Zighhi/DSPAmp/thesis/Appendix1.tex

\chapter{Schema Hardware a Sistemului}
\label{anexa:hardware}

\vspace{-2cm}
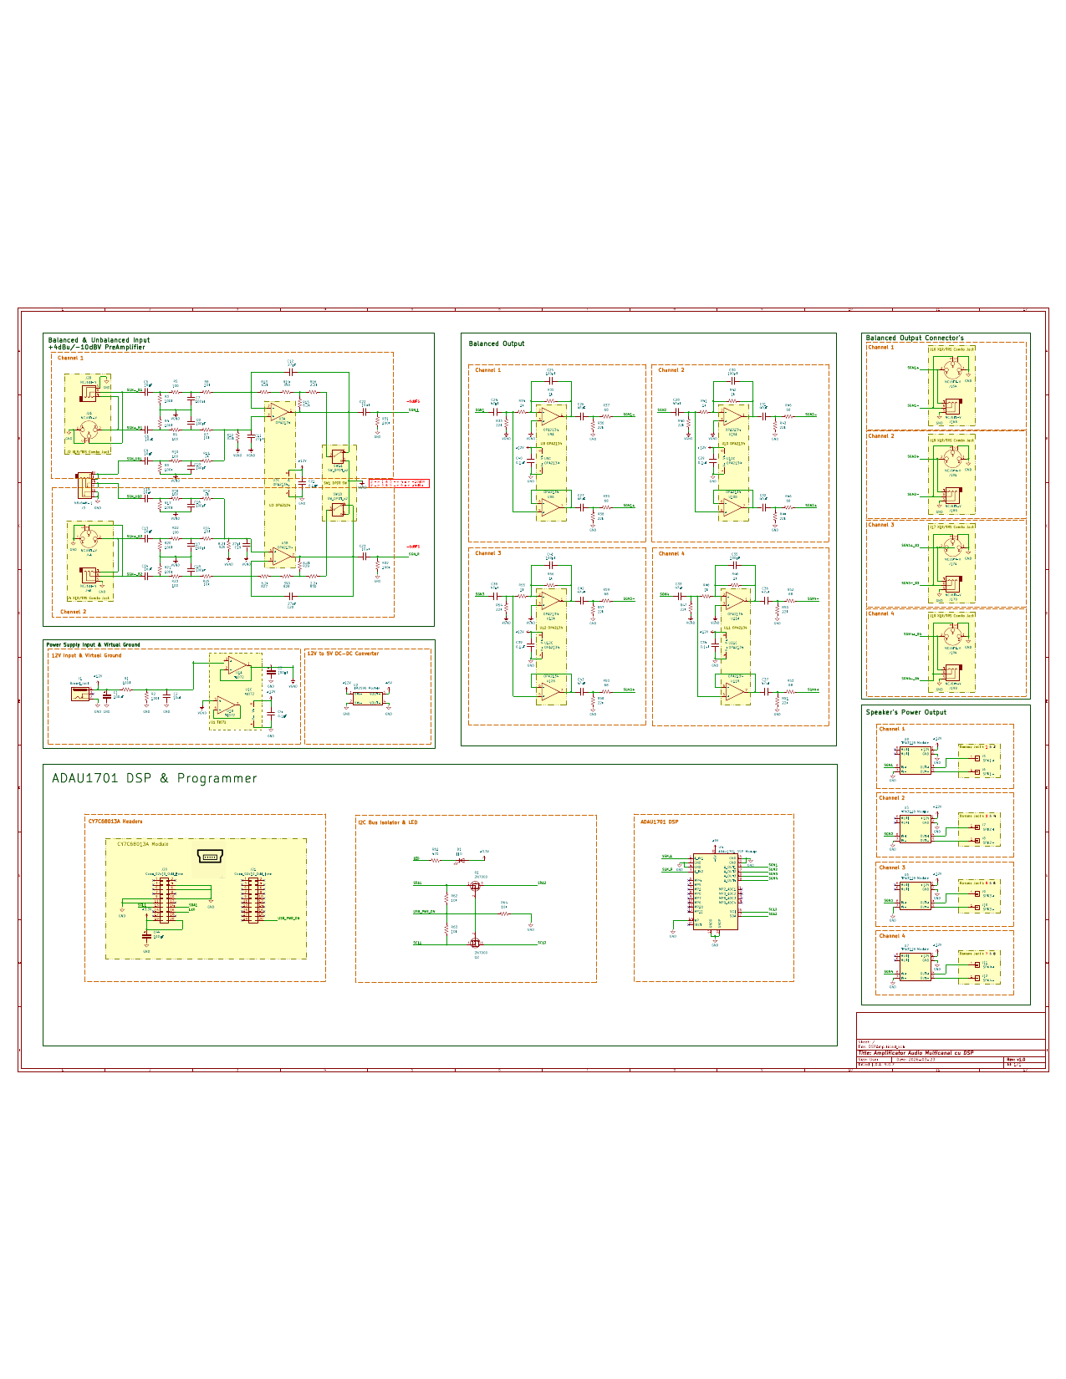
[picture p4: thesis/figuri/schema_completa.png]
\noindent
