Zighhi/DSPAmp/docs/images/block_diagram.png

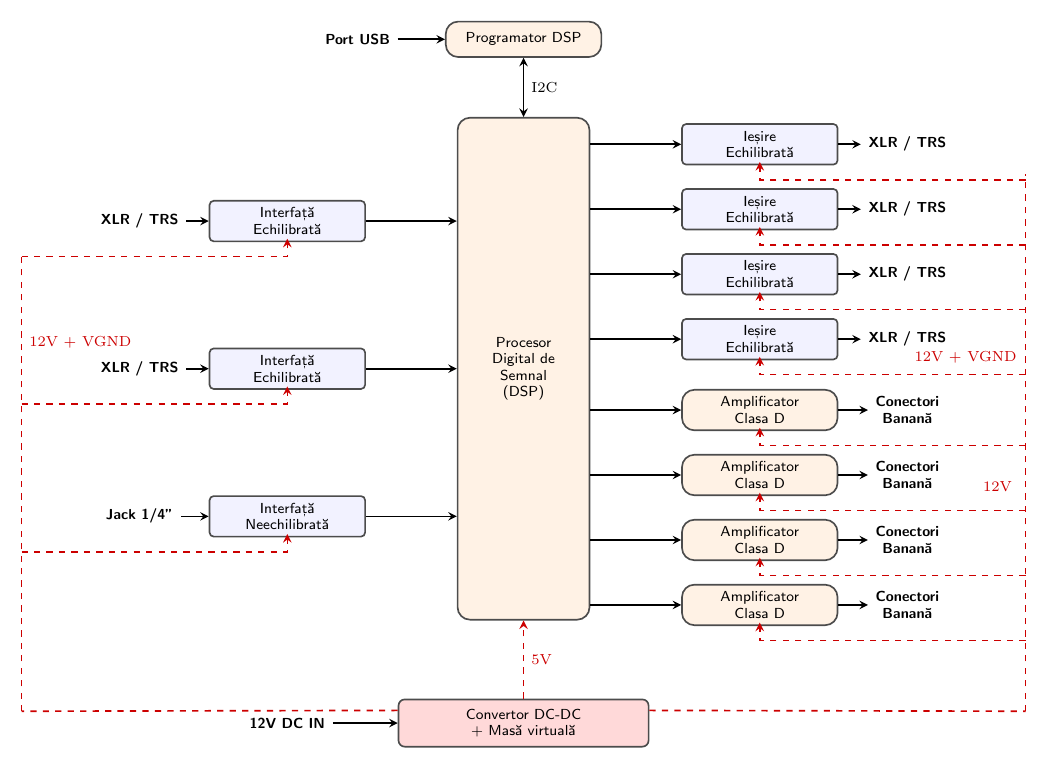
docs/images/block_diagram.png
