Zighhi/DSPAmp/hardware/DSPAmp_schematic.pdf

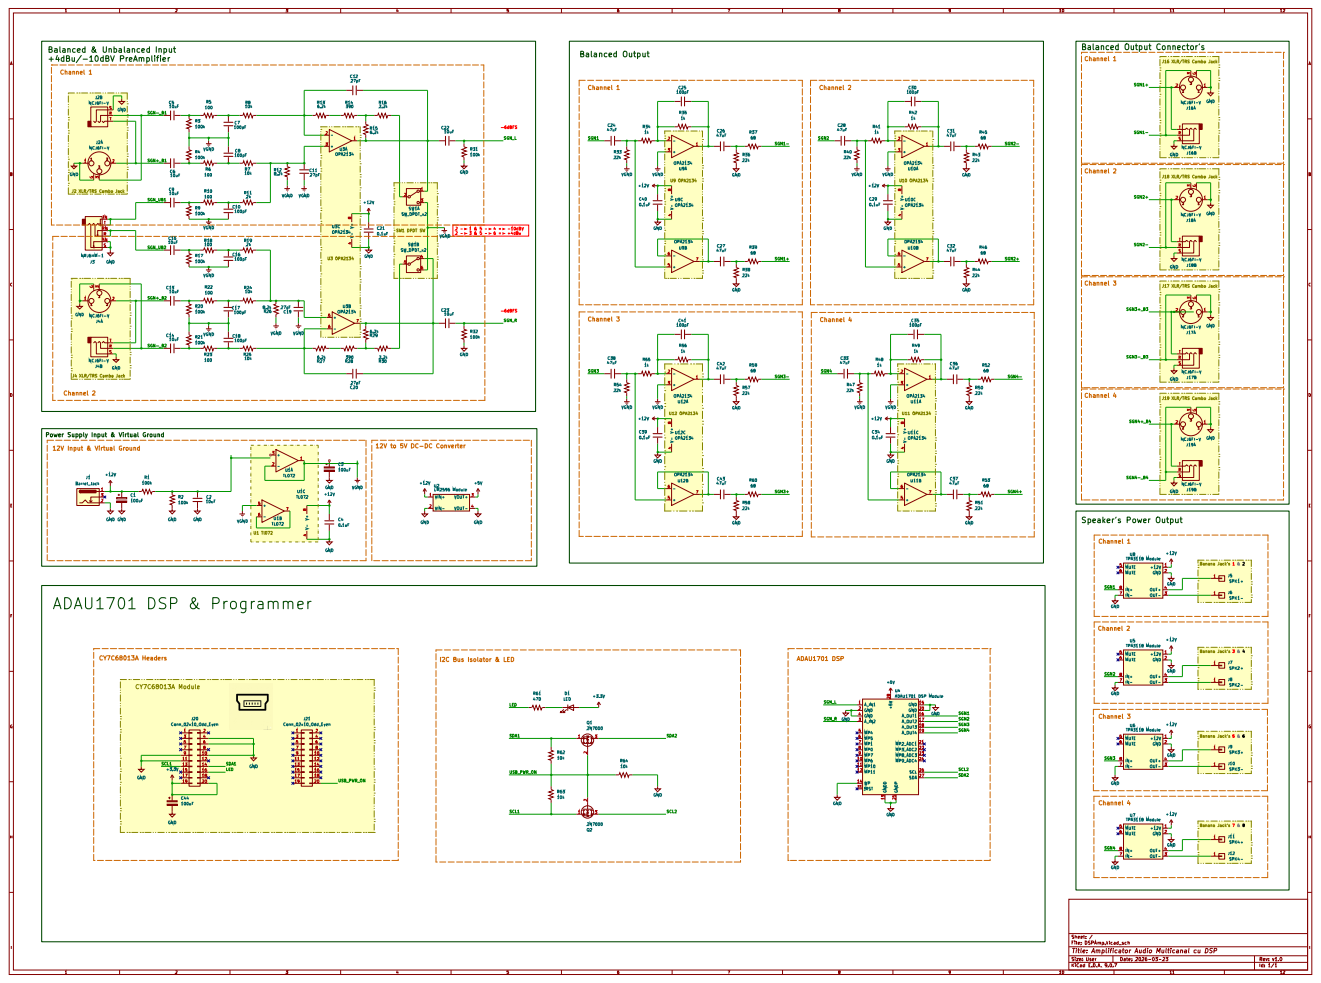
[picture p31: page 1]
