Zighhi/DSPAmp/thesis/figuri/cmrr_signals.pdf

101

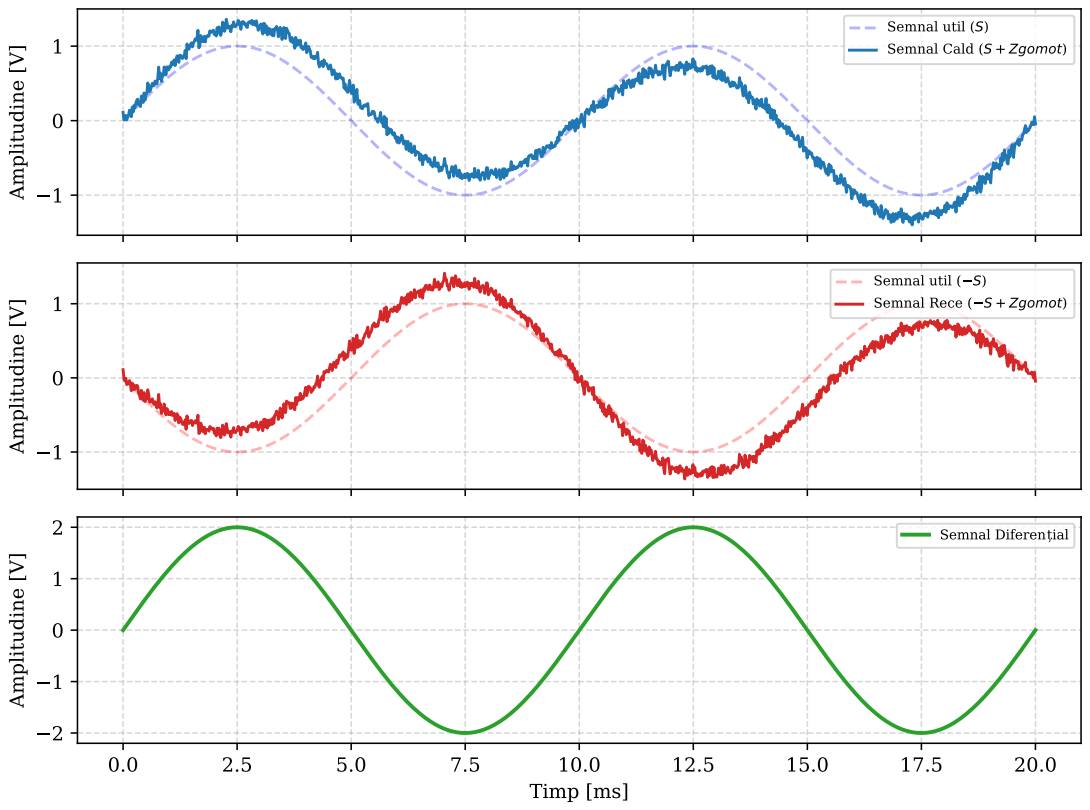
[picture p33: page 1]
Amplitudine [V]; Timp [ms]

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

Semnal Diferen ial
