Zighhi/DSPAmp/thesis/figuri/freq_resp_input.pdf

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

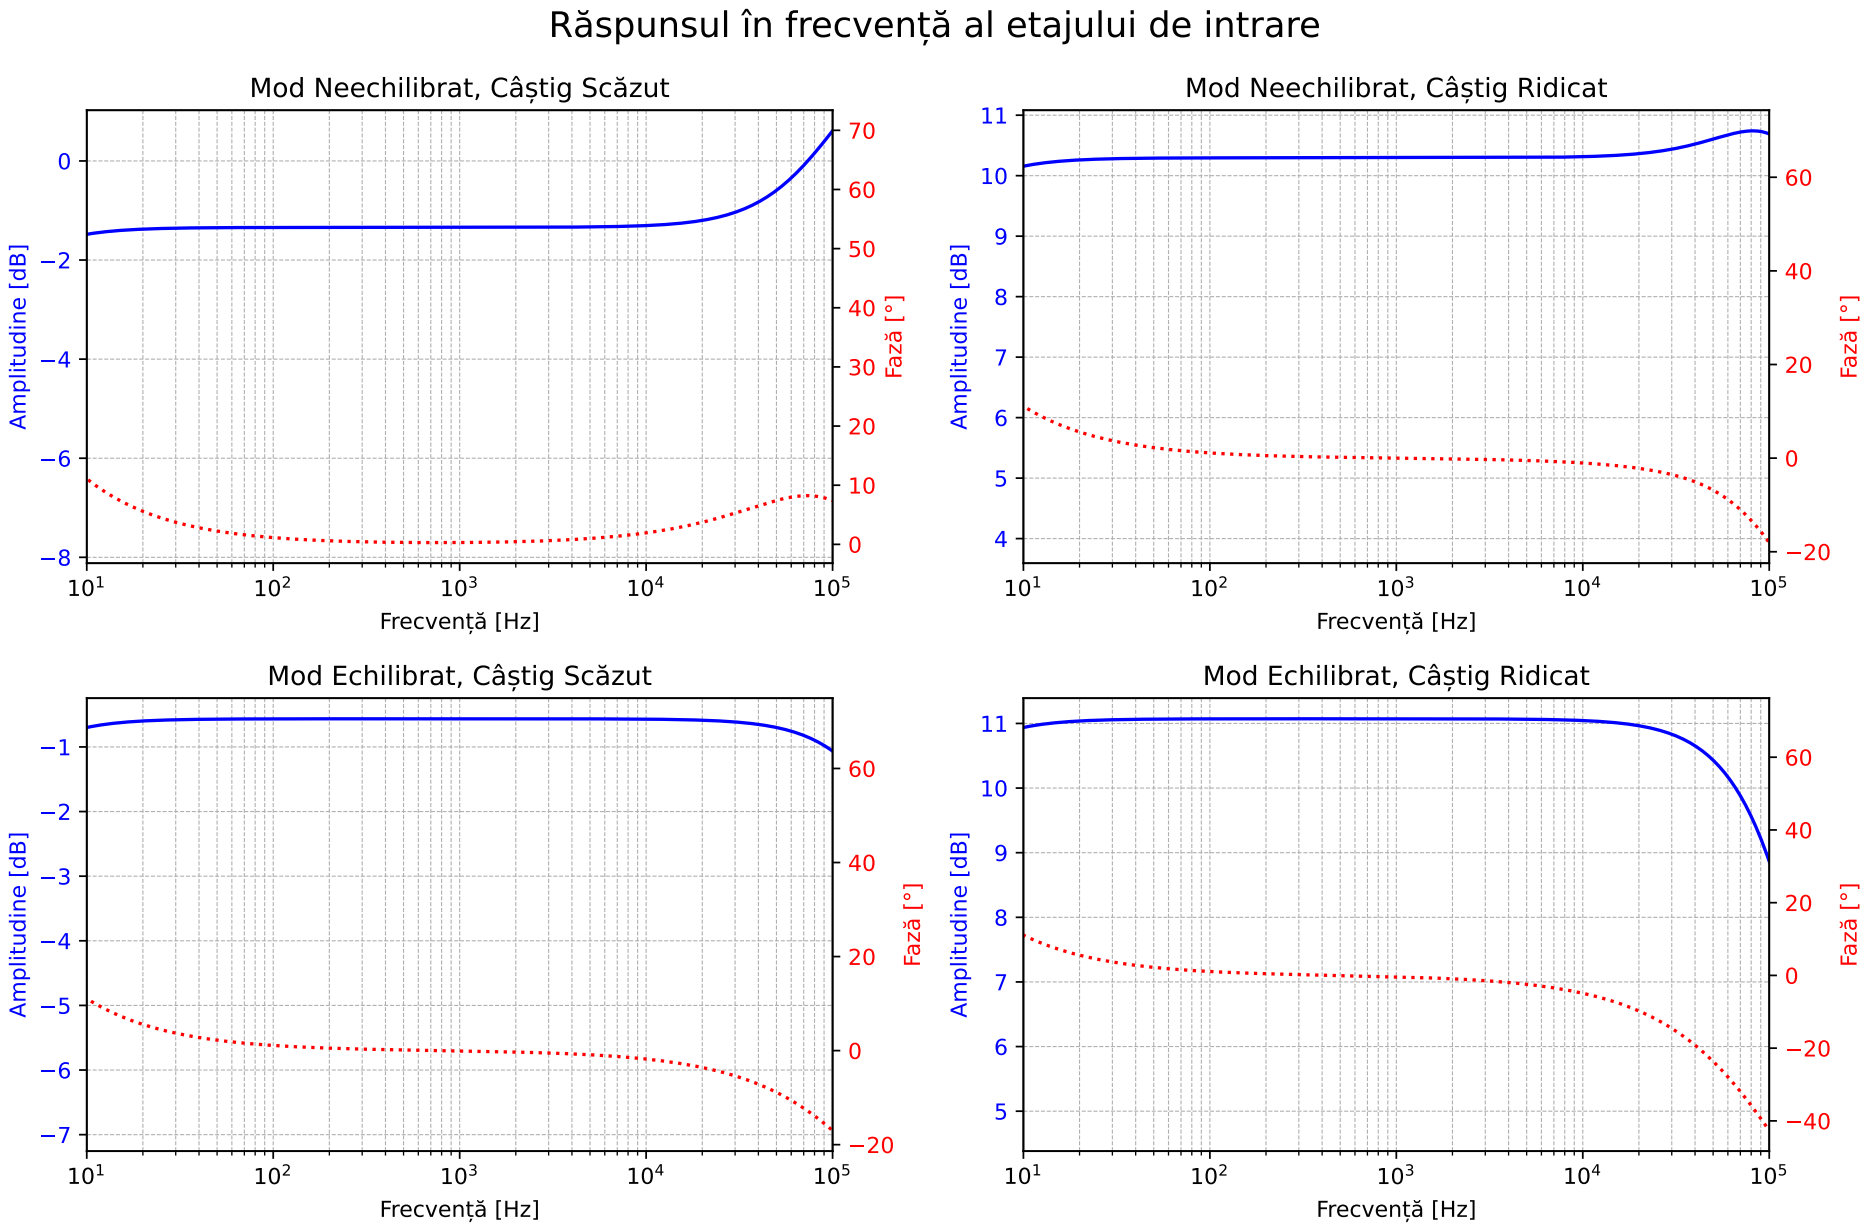
[picture p35: page 1]
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
