Zighhi/DSPAmp/simulations/Input Interface.asc

C1: cap; 10µ; V=35
C2: cap; 10µ; V=35
C3: cap; 100p
C4: cap; 100p
C5: cap; 27pF
C6: cap; 27pF
C8: cap; 10µ; V=35
C9: cap; 100p
C13: cap; 10µ; V=35
Cold: signal; SINE(0 0.868 1K 0 0 180); AC -0.5
Hot: signal; SINE(0 0.868 1K 0 0 0); AC 0.5
R1: res; 100k
R2: res; 100k
R3: res; 100
R4: res; 100
R5: res; 100k
R6: res; 2k
R7: res; 10k
R8: res; 10k
R9: res; 8.2k
R10: res; 8.2k
R13: res; 100
R14: res; 390
R15: res; 6.2k
R16: res; 100k
R17: res; 100k
R18: res; 2.2k
R24: res; 100k
U1: opamp
U3: opamp
unbalanced: signal; SINE(0 1.736 1K 0 0 0); AC 1
V1: voltage; 12
Named nets: 0, VGND, Cold, +12V, Hot, out
.lib opamp.sub
.tran 0.005
--- Signal Level Cheat Sheet ---
 +4dBu Signal:
 RMS Voltage = 1.23V
 Peak Amplitude for SINE source = 1.736V
 
 -10dBV Signal:
 RMS Voltage = 0.316V
 Peak Amplitude for SINE source = 0.447V
 
 -6dBFS (ADAU1401 Target Level):
 RMS Voltage = 1.0V
 Peak Amplitude for SINE source = 1.414V
.ac oct 100 1 100k
High Gain
