Zighhi/DSPAmp/simulations/Output_Interface.asc

C1: cap; 47µ; V=35
C2: cap; 100p
C3: cap; 47µF; V=35
C4: cap; 47µF; V=35
Cold1: signal; SINE(0 1.736 1K 0 0 180); AC 1
R1: res; 1k
R2: res; 22k
R3: res; 1k
R4: res; 22k
R5: res; 68
R6: res; 68
R7: res; 22k
R8: res; 100k
R9: res; 100k
U1: opamp
U2: opamp
U3: opamp
V1: voltage; 12
Named nets: 0, VGND, +12V, hot, cold
.tran 0.01
.lib opamp.sub
.ac oct 10 20 1MEG
--- Signal Level Cheat Sheet ---
 +4dBu Signal:
 RMS Voltage = 1.23V
 Peak Amplitude for SINE source = 1.736V
 
 -10dBV Signal:
 RMS Voltage = 0.316V
 Peak Amplitude for SINE source = 0.447V
 
 -6dBFS (ADAU1401 Target Level):
 RMS Voltage = 1.0V
 Peak Amplitude for SINE source = 1.414V
