Zighhi/DSPAmp/simulations/Virtual_Ground.asc

C1: cap; 100u
C2: cap; 10u
C3: cap; 100u
I_AC: current; 0; AC 1
I_STEP: current; PULSE(0 10m 10u 1u 1u 1m 2m)
R1: res; 100k
R2: res; 100k
U1: opamp; TL072
V_IN: voltage; 12
Named nets: 0, vgnd
.lib opamp.sub
.ac oct 100 1 100k
.tran 0 5m 0 1u
Virtual Ground Performance - Final Verified Schematic
