Zighhi/DSPAmp/hardware/DSPAmp.kicad_sch

## KiCad design hardware/DSPAmp.kicad_sch (2026-10-09)

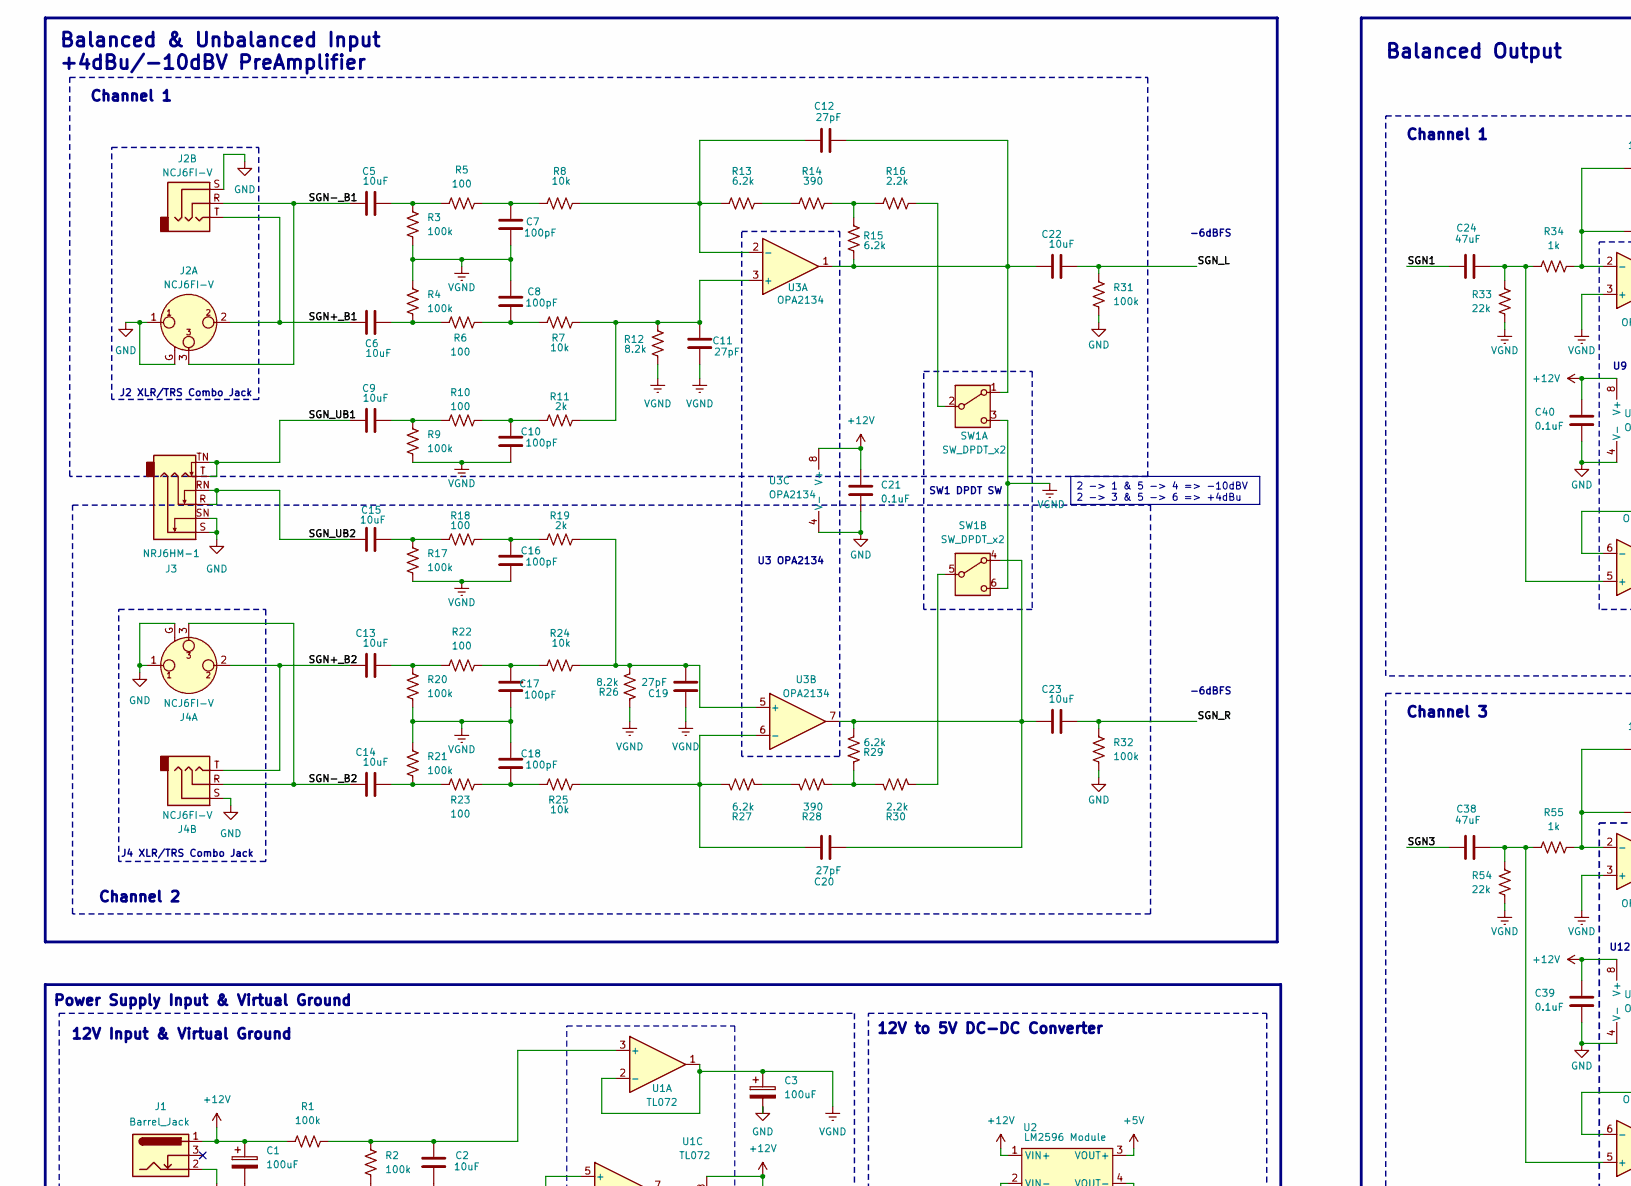
[picture p42: schematic DSPAmp.kicad_sch, part in row 1, column 1]

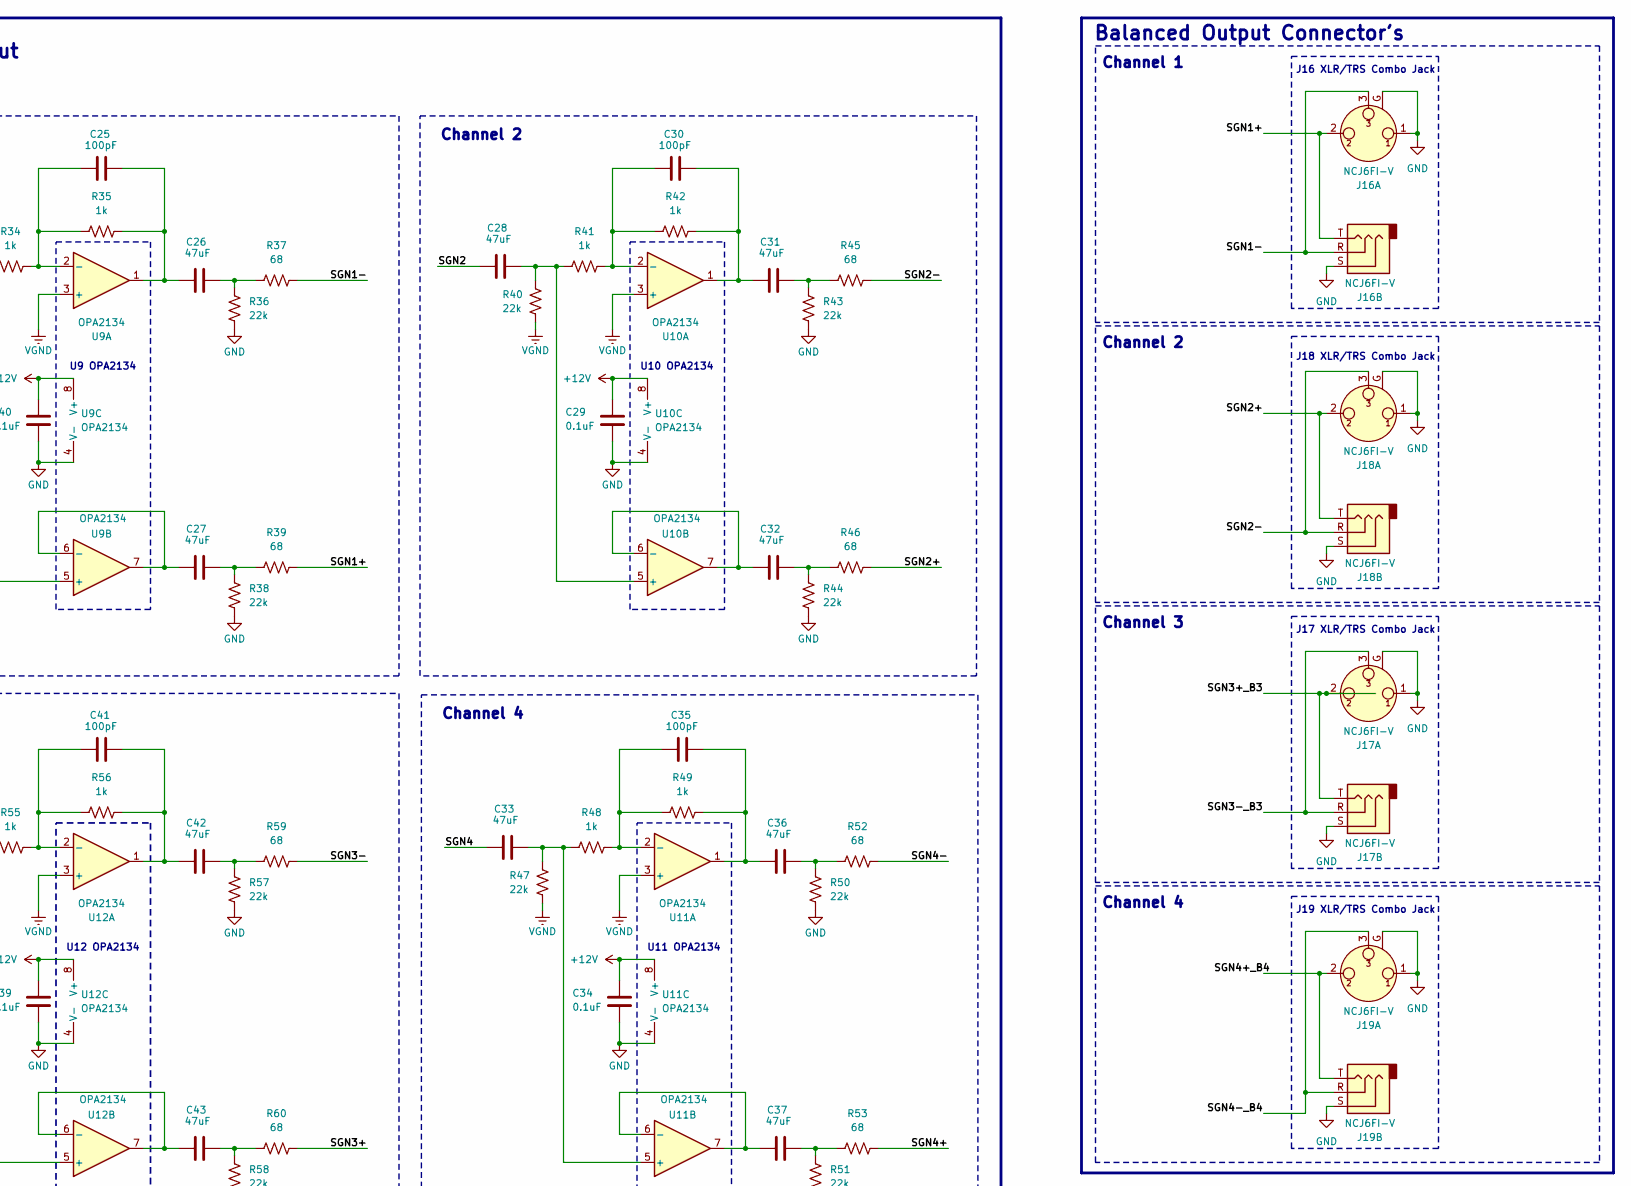
[picture p43: schematic DSPAmp.kicad_sch, part in row 1, column 2]

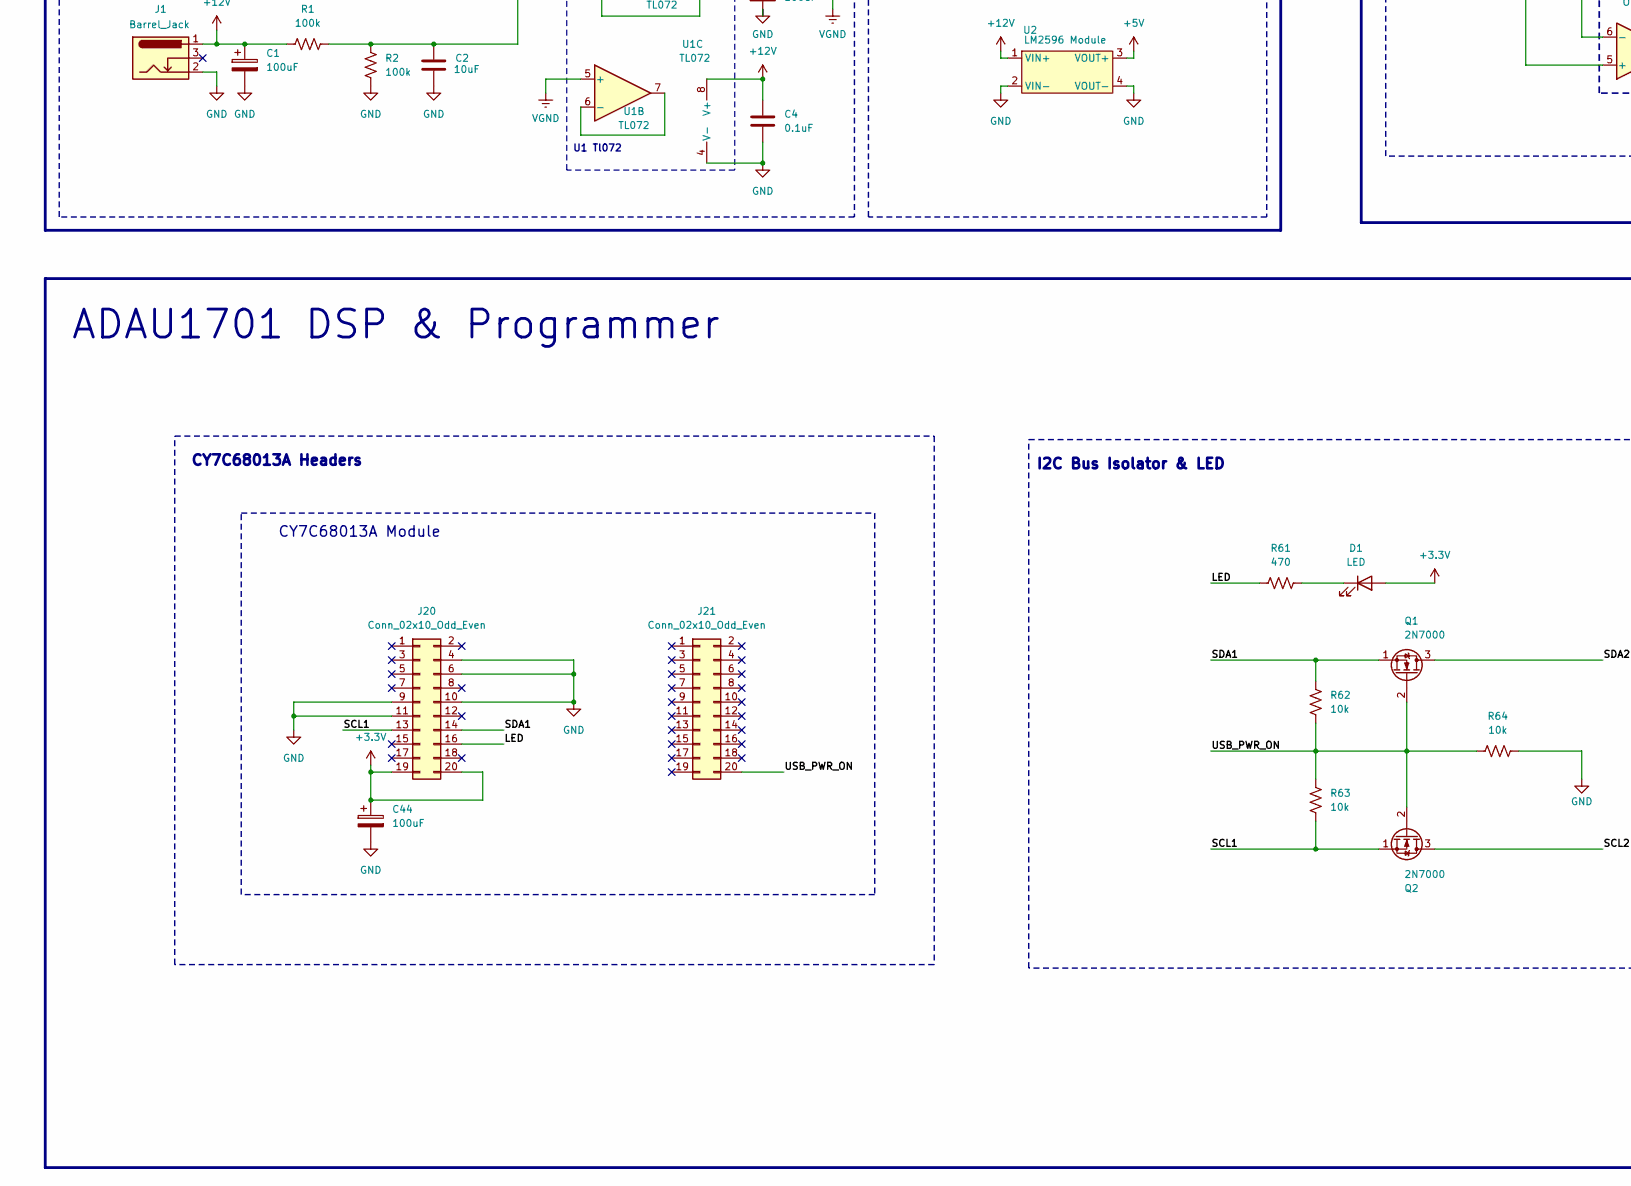
[picture p44: schematic DSPAmp.kicad_sch, part in row 2, column 1]

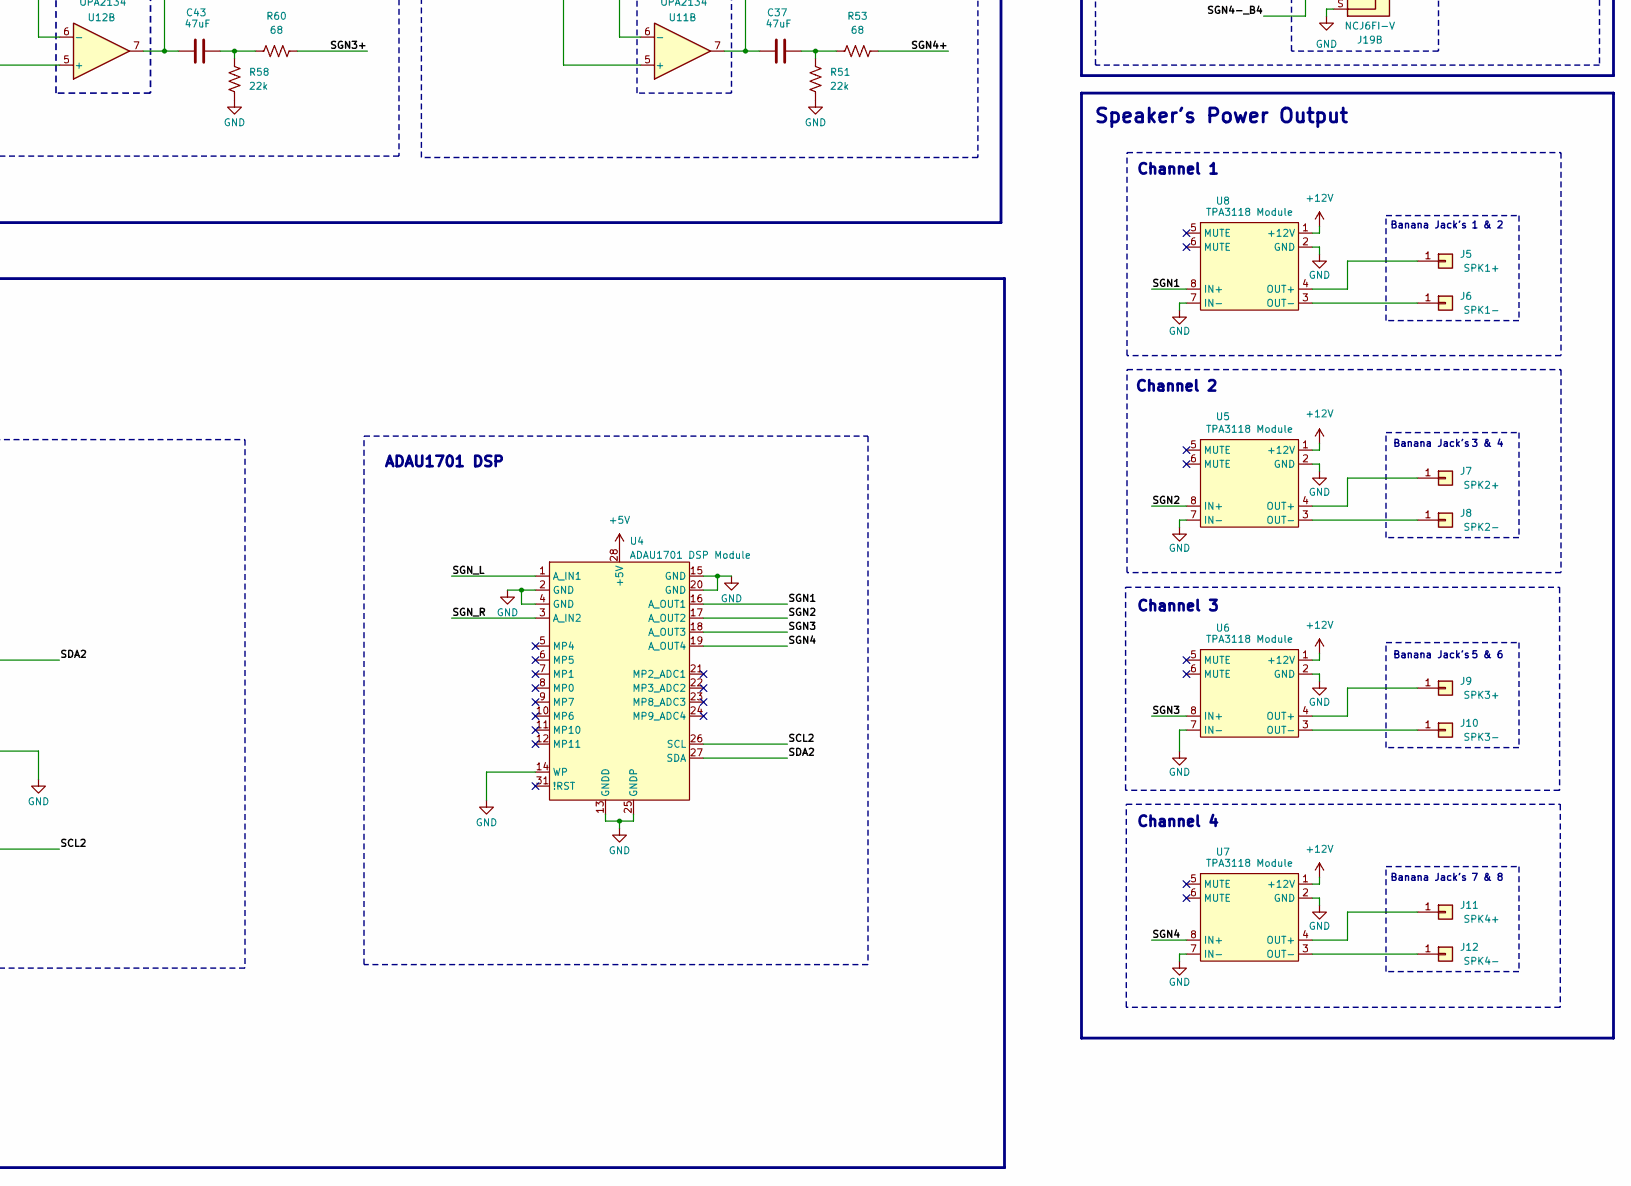
[picture p45: schematic DSPAmp.kicad_sch, part in row 2, column 2]

Parts:
C1, C3, C44: 100uF
C2, C5, C6, C9, C13, C14, C15, C22, C23: 10uF
C4, C21, C29, C34, C39, C40: 0.1uF
C7, C8, C10, C16, C17, C18, C25, C30, C35, C41: 100pF
C11, C12, C19, C20: 27pF
C24, C26, C27, C28, C31, C32, C33, C36, C37, C38, C42, C43: 47uF
D1: LED
J1: Barrel_Jack
J2, J4, J16, J17, J18, J19: NCJ6FI-V; Jack_XLR-6.35mm_Neutrik_NCJ6FI-V_Vertical
J3: NRJ6HM-1; Jack_6.35mm_Neutrik_NRJ6HM-1_Horizontal
J5: SPK1+
J6: SPK1-
J7: SPK2+
J8: SPK2-
J9: SPK3+
J10: SPK3-
J11: SPK4+
J12: SPK4-
J20, J21: Conn_02x10_Odd_Even
Q1, Q2: 2N7000; TO-92_Inline
R1, R2, R3, R4, R9, R17, R20, R21, R31, R32: 100k
R5, R6, R10, R18, R22, R23: 100
R7, R8, R24, R25, R62, R63, R64: 10k
R11, R19: 2k
R12, R26: 8.2k
R13, R15, R27, R29: 6.2k
R14, R28: 390
R16, R30: 2.2k
R33, R36, R38, R40, R43, R44, R47, R50, R51, R54, R57, R58: 22k
R34, R35, R41, R42, R48, R49, R55, R56: 1k
R37, R39, R45, R46, R52, R53, R59, R60: 68
R61: 470
SW1: SW_DPDT_x2
U1: TL072
U2: LM2596 Module
U3: OPA2134; DIP-8_W7.62mm
U4: ADAU1701 DSP Module
U5, U6, U7, U8: TPA3118 Module
U9, U10, U11, U12: OPA2134

Connections:
+3.3V: C44.1, D1.2 (A), J20.19, J20.20
+5V: U2.3 (VOUT+), U4.28 (+5V)
+12V: C1.1, C4.1, C21.1, C29.2, C34.2, C39.2, C40.2, J1.1, R1.2, U1.8 (V+), U2.1 (VIN+), U3.8 (V+), U5.1 (+12V), U6.1 (+12V), U7.1 (+12V), U8.1 (+12V), U9.8 (V+), U10.8 (V+), U11.8 (V+), U12.8 (V+)
GND: C1.2, C2.2, C3.2, C4.2, C21.2, C29.1, C34.1, C39.1, C40.1, C44.2, J1.2, J2.1, J2.G, J2.S, J3.S, J3.SN, J4.1, J4.G, J4.S, J16.1, J16.G, J16.S, J17.1, J17.G, J17.S, J18.1, J18.G, J18.S, J19.1, J19.G, J19.S, J20.4, J20.6, J20.9, J20.10, J20.11, R2.2, R31.2, R32.2, R36.2, R38.2, R43.2, R44.2, R50.2, R51.2, R57.2, R58.2, R64.1, U1.4 (V-), U2.2 (VIN-), U2.4 (VOUT-), U3.4 (V-), U4.2 (GND), U4.4 (GND), U4.13 (GNDD), U4.14 (WP), U4.15 (GND), U4.20 (GND), U4.25 (GNDP), U5.2 (GND), U5.7 (IN-), U6.2 (GND), U6.7 (IN-), U7.2 (GND), U7.7 (IN-), U8.2 (GND), U8.7 (IN-), U9.4 (V-), U10.4 (V-), U11.4 (V-), U12.4 (V-)
LED: J20.16, R61.1
unnamed: C2.1, R1.1, R2.1, U1.3 (+)
unnamed: C5.2, R3.1, R5.1
unnamed: C6.2, R4.2, R6.1
unnamed: C7.2, R5.2, R8.1
unnamed: C8.1, R6.2, R7.1
unnamed: C9.2, R9.1, R10.1
unnamed: C10.2, R10.2, R11.1
unnamed: C11.2, R7.2, R11.2, R12.2, U3.3 (+)
unnamed: C12.1, C22.1, R15.1, SW1.1 (A), U3.1
unnamed: C12.2, R8.2, R13.1, U3.2 (-)
unnamed: C13.2, R20.1, R22.1
unnamed: C14.2, R21.2, R23.1
unnamed: C15.2, R17.1, R18.1
unnamed: C16.2, R18.2, R19.1
unnamed: C17.2, R22.2, R24.1
unnamed: C18.1, R23.2, R25.1
unnamed: C19.2, R19.2, R24.2, R26.2, U3.5 (+)
unnamed: C20.1, C23.1, R29.1, SW1.4 (A), U3.7
unnamed: C20.2, R25.2, R27.1, U3.6 (-)
unnamed: C24.2, R33.1, R34.1, U9.5 (+)
unnamed: C25.1, C26.1, R35.2, U9.1
unnamed: C25.2, R34.2, R35.1, U9.2 (-)
unnamed: C26.2, R36.1, R37.1
unnamed: C27.1, U9.6 (-), U9.7
unnamed: C27.2, R38.1, R39.1
unnamed: C28.2, R40.1, R41.1, U10.5 (+)
unnamed: C30.1, C31.1, R42.2, U10.1
unnamed: C30.2, R41.2, R42.1, U10.2 (-)
unnamed: C31.2, R43.1, R45.1
unnamed: C32.1, U10.6 (-), U10.7
unnamed: C32.2, R44.1, R46.1
unnamed: C33.2, R47.1, R48.1, U11.5 (+)
unnamed: C35.1, C36.1, R49.2, U11.1
unnamed: C35.2, R48.2, R49.1, U11.2 (-)
unnamed: C36.2, R50.1, R52.1
unnamed: C37.1, U11.6 (-), U11.7
unnamed: C37.2, R51.1, R53.1
unnamed: C38.2, R54.1, R55.1, U12.5 (+)
unnamed: C41.1, C42.1, R56.2, U12.1
unnamed: C41.2, R55.2, R56.1, U12.2 (-)
unnamed: C42.2, R57.1, R59.1
unnamed: C43.1, U12.6 (-), U12.7
unnamed: C43.2, R58.1, R60.1
unnamed: D1.1 (K), R61.2
unnamed: J5.1, U8.4 (OUT+)
unnamed: J6.1, U8.3 (OUT-)
unnamed: J7.1, U5.4 (OUT+)
unnamed: J8.1, U5.3 (OUT-)
unnamed: J9.1, U6.4 (OUT+)
unnamed: J10.1, U6.3 (OUT-)
unnamed: J11.1, U7.4 (OUT+)
unnamed: J12.1, U7.3 (OUT-)
unnamed: R13.2, R14.1
unnamed: R14.2, R15.2, R16.1
unnamed: R16.2, SW1.2 (B)
unnamed: R27.2, R28.1
unnamed: R28.2, R29.2, R30.1
unnamed: R30.2, SW1.5 (B)
unnamed: U1.6 (-), U1.7
SCL1: J20.13, Q2.1 (S), R63.1
SCL2: Q2.3 (D), U4.26 (SCL)
SDA1: J20.14, Q1.1 (S), R62.2
SDA2: Q1.3 (D), U4.27 (SDA)
SGN1: C24.1, U4.16 (A_OUT1), U8.8 (IN+)
SGN1+: J16.2, J16.T, R39.2
SGN1-: J16.3, J16.R, R37.2
SGN2: C28.1, U4.17 (A_OUT2), U5.8 (IN+)
SGN2+: J18.2, J18.T, R46.2
SGN2-: J18.3, J18.R, R45.2
SGN3: C38.1, U4.18 (A_OUT3), U6.8 (IN+)
SGN3+: R60.2
SGN3+_B3: J17.2, J17.T
SGN3-: R59.2
SGN3-_B3: J17.3, J17.R
SGN4: C33.1, U4.19 (A_OUT4), U7.8 (IN+)
SGN4+: R53.2
SGN4+_B4: J19.2, J19.T
SGN4-: R52.2
SGN4-_B4: J19.3, J19.R
SGN+_B1: C6.1, J2.2, J2.T
SGN+_B2: C13.1, J4.2, J4.T
SGN-_B1: C5.1, J2.3, J2.R
SGN-_B2: C14.1, J4.3, J4.R
SGN_L: C22.2, R31.1, U4.1 (A_IN1)
SGN_R: C23.2, R32.1, U4.3 (A_IN2)
SGN_UB1: C9.1, J3.T, J3.TN
SGN_UB2: C15.1, J3.R, J3.RN
USB_PWR_ON: J21.20, Q1.2 (G), Q2.2 (G), R62.1, R63.2, R64.2
VGND: C3.1, C7.1, C8.2, C10.1, C11.1, C16.1, C17.1, C18.2, C19.1, R3.2, R4.1, R9.2, R12.1, R17.2, R20.2, R21.1, R26.1, R33.2, R40.2, R47.2, R54.2, SW1.3 (C), SW1.6 (C), U1.1, U1.2 (-), U1.5 (+), U9.3 (+), U10.3 (+), U11.3 (+), U12.3 (+)

Notes on the sheet:
Channel 2
-6dBFS
U9 OPA2134
I2C Bus Isolator & LED
U1 Tl072
ADAU1701 DSP
Banana Jack's
Balanced & Unbalanced Input +4dBu/-10dBV PreAmplifier
12V to 5V DC-DC Converter
Banana Jack's
Channel 4
Channel 1
J2 XLR/TRS Combo Jack
U12 OPA2134
U10 OPA2134
Channel 3
J4 XLR/TRS Combo Jack
ADAU1701 DSP & Programmer
Channel 2
12V Input & Virtual Ground
U3 OPA2134
Balanced Output
CY7C68013A Module
SW1 DPDT SW
U11 OPA2134
J17 XLR/TRS Combo Jack
J19 XLR/TRS Combo Jack
Balanced Output Connector's
J16 XLR/TRS Combo Jack
Speaker's Power Output
Power Supply Input & Virtual Ground
CY7C68013A Headers
Channel 3
J18 XLR/TRS Combo Jack
2 -> 1 & 5 -> 4 => -10dBV 2 -> 3 & 5 -> 6 => +4dBu
